KasperT00/TheRobotArm/PlanetaryDesign/CompoundPlanetaryCalculation.xlsx

Compound planetary slip ring gearbox ratio and parameters
With this spreadsheet, user can calculate the amount of teeth, module size, teeth size, gear distances and gear ratio of the given compound planetary slip ring gear design
Modify the values that are market with Orange
Nema 23 | Teeth and parameters |  |  |  |  | Gear radius
Stage | Ring | Sun | Planet = (Ring-Sun) / 2 | Module |  | Ring | Sun | Planet | Distance to planet (Modules should equal in order for the planets to be connected) | Ring diameter
Stage 1 | 74 | 22 | 26 | 0.9 |  | 33.3 | 9.9 | 11.7 | 21.6
Stage 2 | 68 | 28 | 20 | 0.9 |  | 30.6 | 12.6 | 9 | 21.6
 |  |  | Ratio= | 26.78787879
Nema 17 | Teeth and parameters |  |  |  |  | Gear radius
Stage | Ring | Sun | Planet = (Ring-Sun) / 2 | Module |  | Ring | Sun | Planet | Distance to planet (Modules should equal in order for the planets to be connected) | Ring diameter
Stage 1 | 74 | 22 | 26 | 0.7 |  | 25.9 | 7.7 | 9.1 | 16.8
Stage 2 | 68 | 28 | 20 | 0.7 |  | 23.8 | 9.8 | 7 | 16.8
 |  |  | Ratio = | 26.78787879
Restrictions:
Zr = Zs+2*Zp | Ring gear number must be equal = sun + 2*planet -gears, this way they fit inside the ring gear
(Zs + Zr)/Np = k | Sun + Ring -gears divided by number of planets must be integer, so that pacing between planets is equal
Stage1DistPlanet = Stage2DistPlanet |  |  | Distance between pkanet ad sun gear center must be equal for both stages so that gears align vertically
For 3 planets | (Ring + sun) / 3 |  |  | Ratio= | S1 / (R1+S1) * (1 - (R1*P2)/(P1*R2) )
Nema 23 | 32
Nema 23 | 32 |  |  | S1= | Sun stage 1
Nema 17 | 32 |  |  | R1= | Ring stage 1
Nema 17 | 32 |  |  | P1= | Planet stage 1
 |  |  |  | R2= | Ring stage 2
For 4 planets | (Ring + sun) / 4 |  |  | P2= | Planet stage 2
Nema 23 | 24
Nema 23 | 24 |  |  | Ratio | X=S1 / (R1+S1) | Y= (1 - (R1*P2)/(P1*R2) ) |  |  | Ratio = 1/(X*Y) = 1:R
Nema 17 | 24 |  |  | Nema 23 | 0.2291666667 | 0.1628959276 |  |  | 26.78787879
Nema 17 | 24 |  |  | Nema 17 | 0.2291666667 | 0.1628959276 |  |  | 26.78787879
