KasperT00/TheRobotArm/Pictures/20250422_102445.jpg

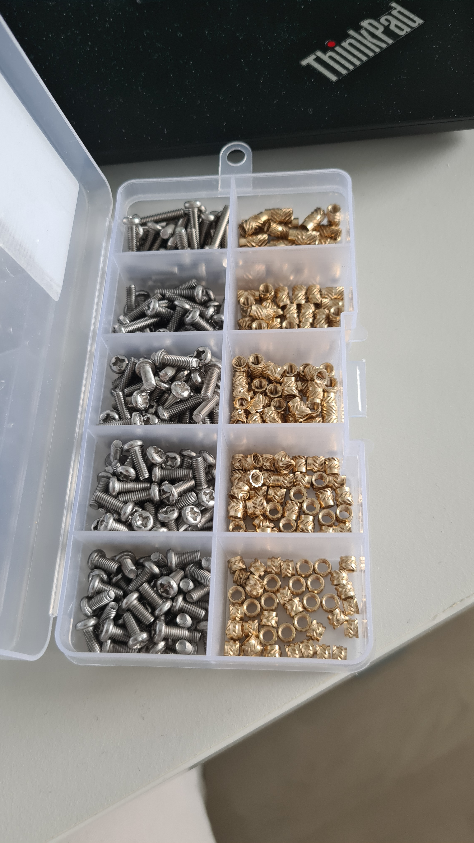
Pictures/20250422_102445.jpg
