KasperT00/TheRobotArm/Pictures/20250422_102539.jpg

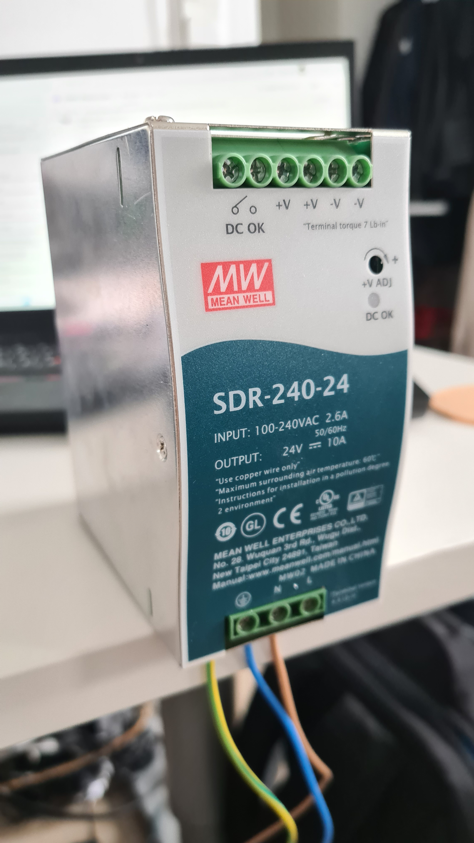
Pictures/20250422_102539.jpg
