KasperT00/TheRobotArm/Pictures/20250424_112915.jpg

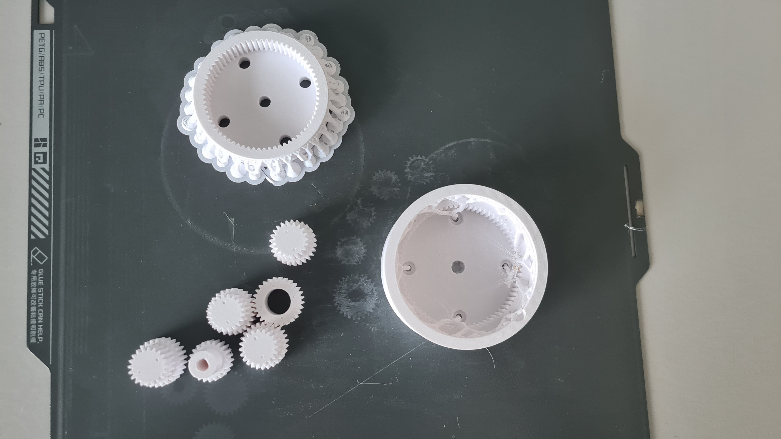
Pictures/20250424_112915.jpg
