KasperT00/TheRobotArm/Pictures/20250425_133735.jpg

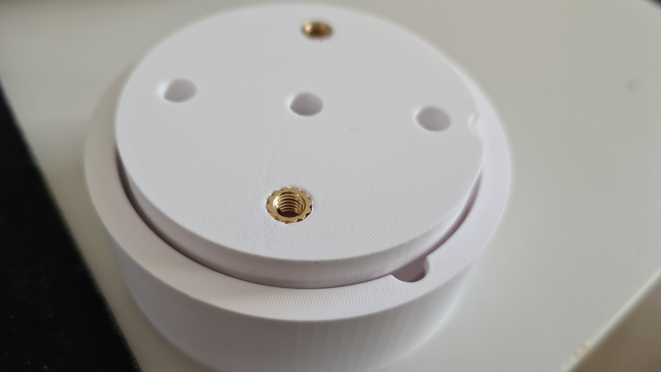
Pictures/20250425_133735.jpg
