KasperT00/TheRobotArm/Pictures/20250506_080510.jpg

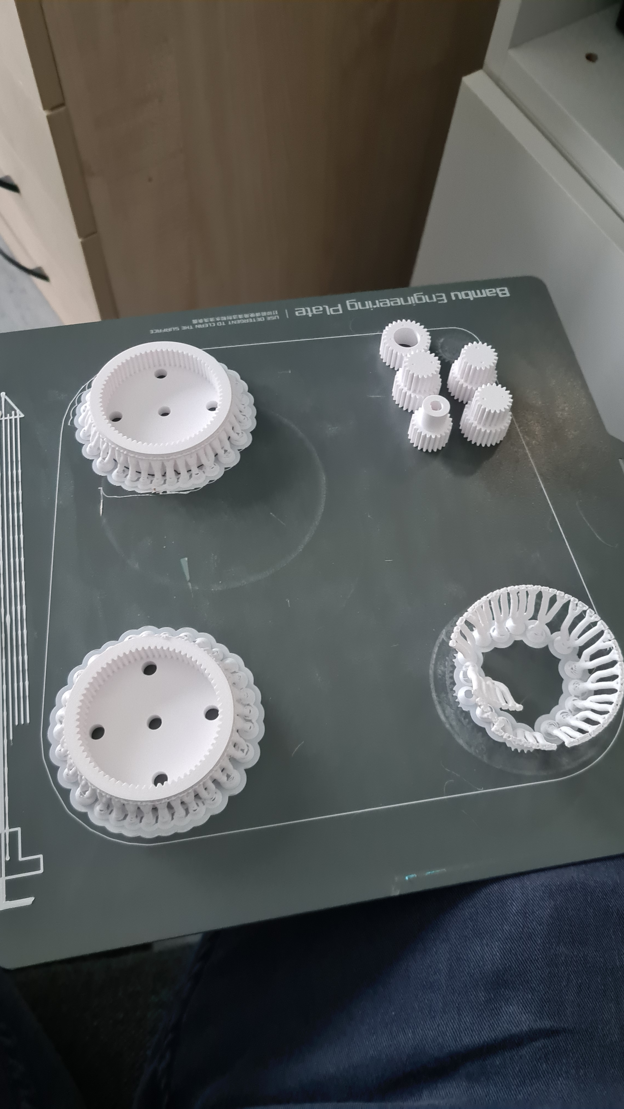
Pictures/20250506_080510.jpg
