KasperT00/TheRobotArm/Pictures/20250515_174201.jpg

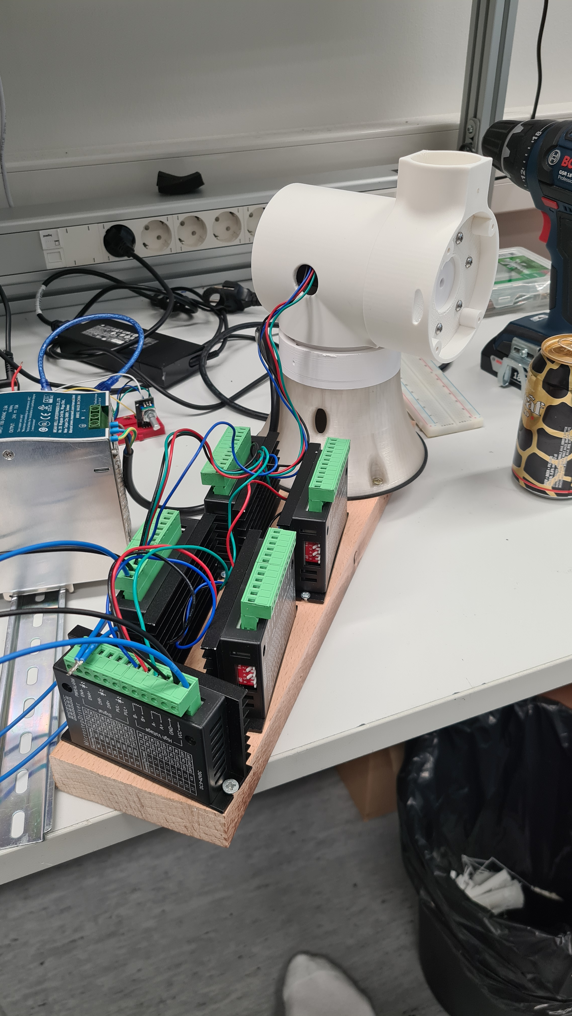
Pictures/20250515_174201.jpg
