KasperT00/TheRobotArm/Pictures/20250515_174206.jpg

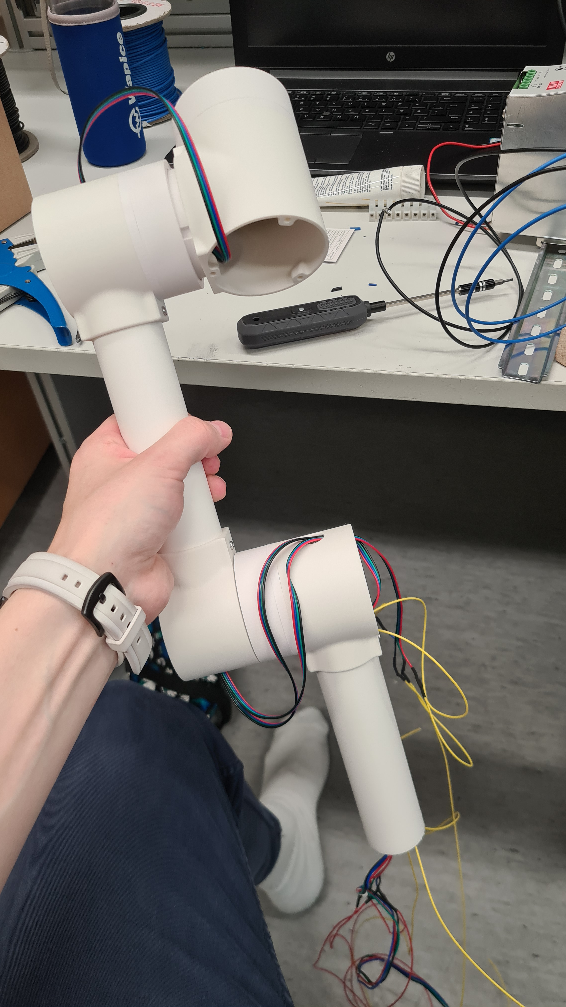
Pictures/20250515_174206.jpg
