KasperT00/TheRobotArm/Pictures/Full3dmodel.png

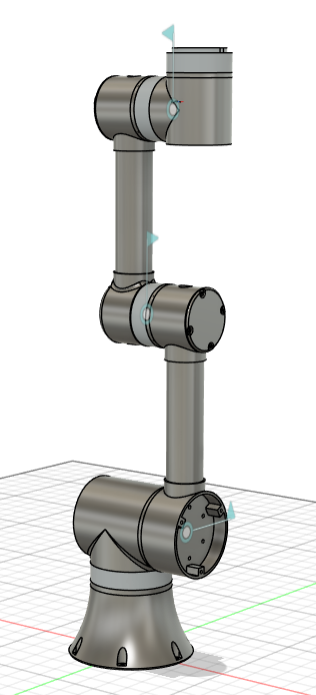
Pictures/Full3dmodel.png
