KasperT00/TheRobotArm/Pictures/hand-skeleton.png

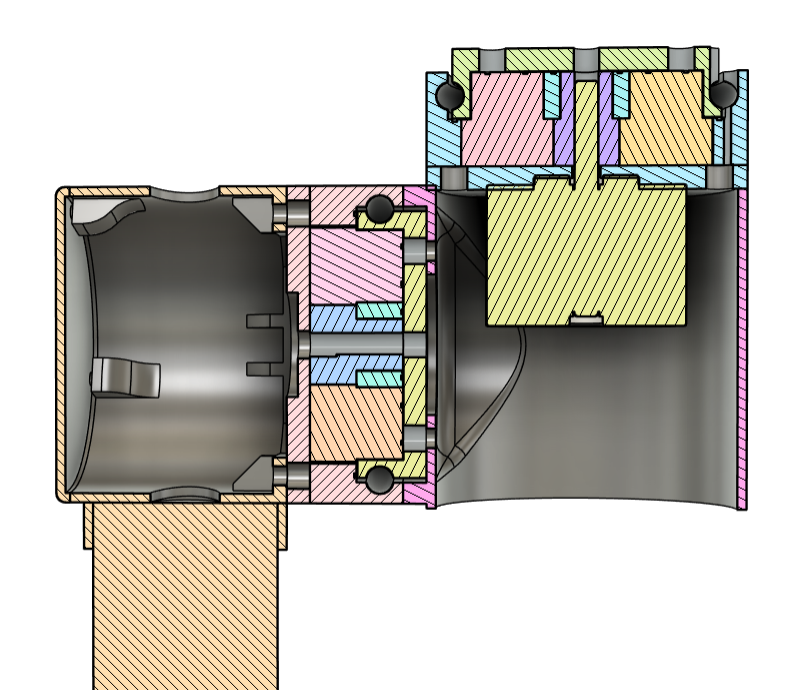
Pictures/hand-skeleton.png
