KasperT00/TheRobotArm/Pictures/middle-skeleton.png

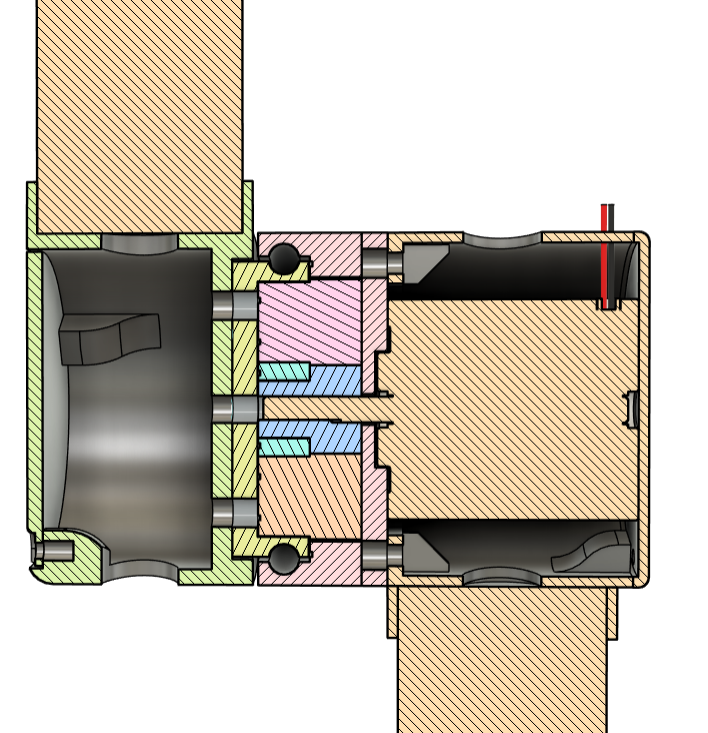
Pictures/middle-skeleton.png
